EngGhaith/The-Silent-Owl-GF180MCU-WB-LNA/docs/sch_gen_v4.png

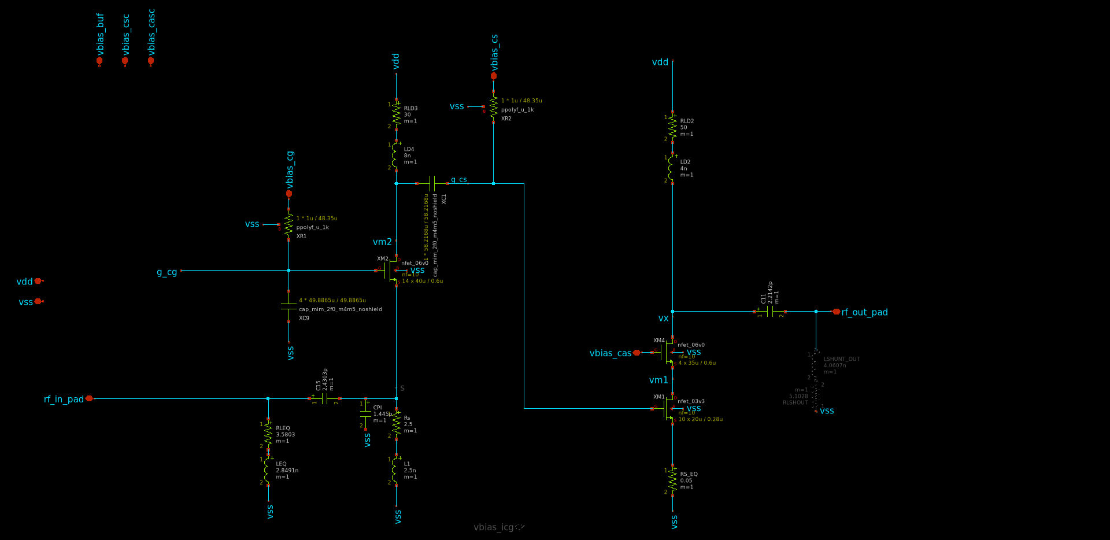
docs/sch_gen_v4.png
