EngGhaith/The-Silent-Owl-GF180MCU-WB-LNA/NFmin_Simulation/results/lna_sweep_analysis/plots_all_data/08_gmid_vs_vgs_nfet_05v0_CS.png

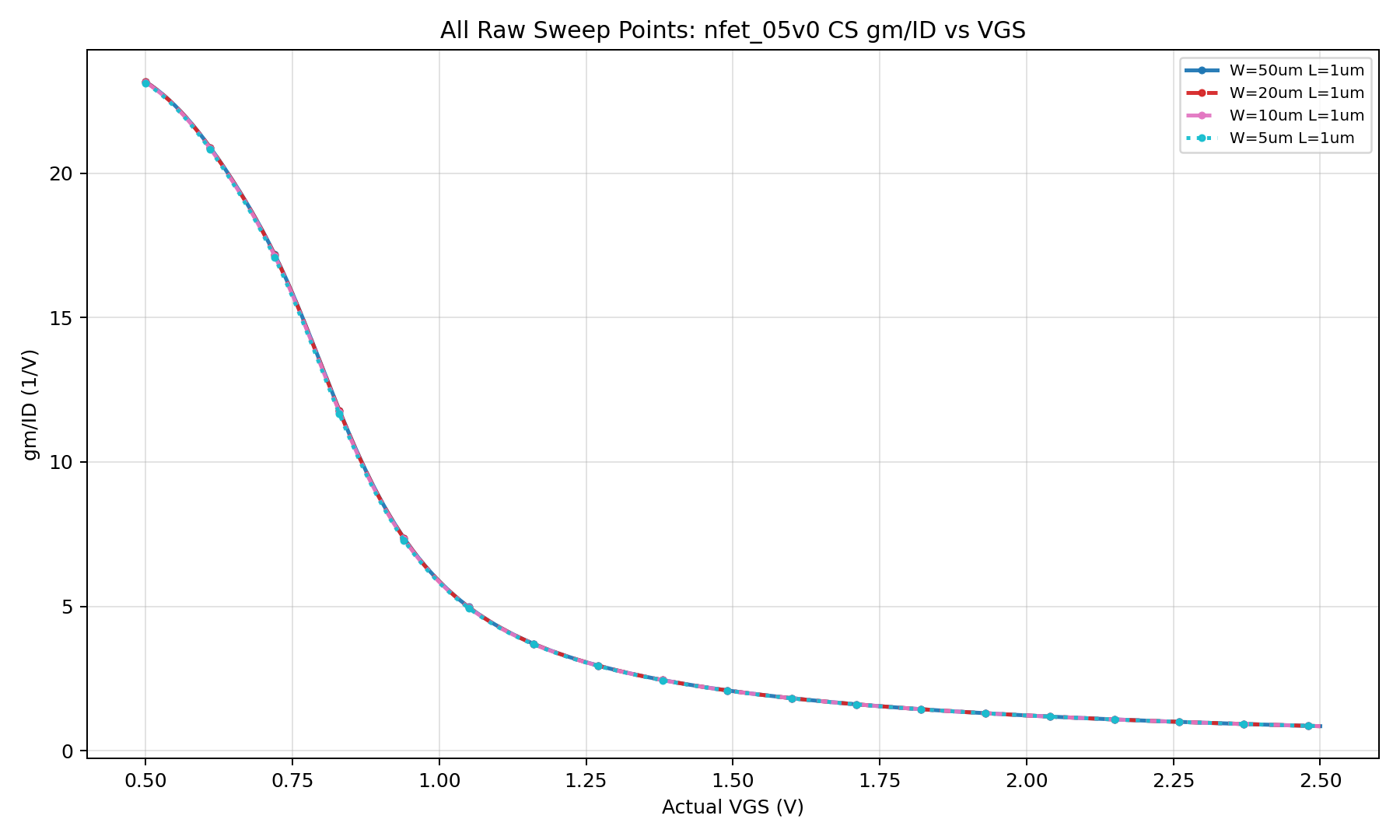
NFmin_Simulation/results/lna_sweep_analysis/plots_all_data/08_gmid_vs_vgs_nfet_05v0_CS.png
