EngGhaith/The-Silent-Owl-GF180MCU-WB-LNA/NFmin_Simulation/results/lna_sweep_analysis/plots_all_data/08_gmid_vs_vgs_nfet_10v0_asym_CG.png

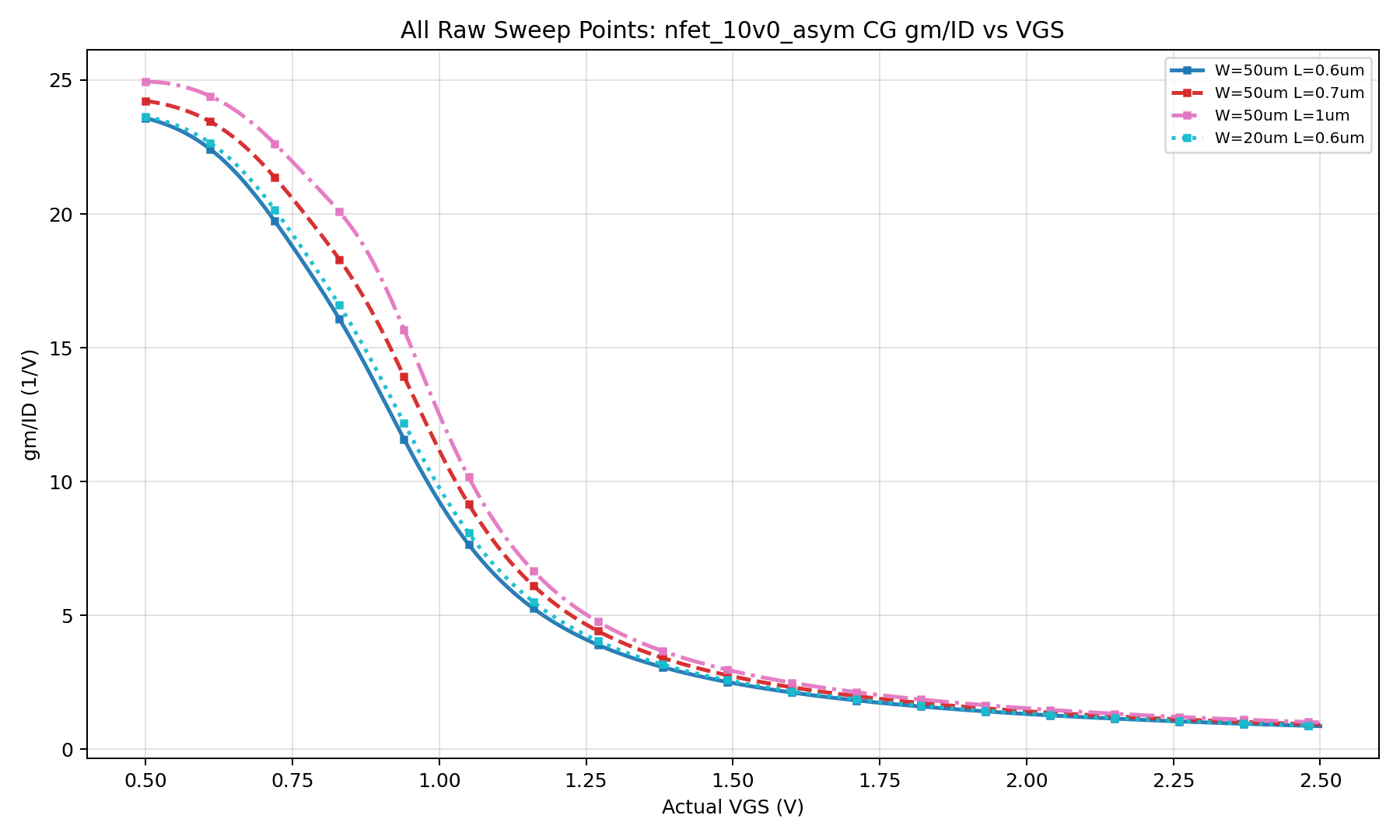
NFmin_Simulation/results/lna_sweep_analysis/plots_all_data/08_gmid_vs_vgs_nfet_10v0_asym_CG.png
