EngGhaith/The-Silent-Owl-GF180MCU-WB-LNA/NFmin_Simulation/results/lna_sweep_analysis/plots_all_data/09_gmgds_vs_gmid_all.png

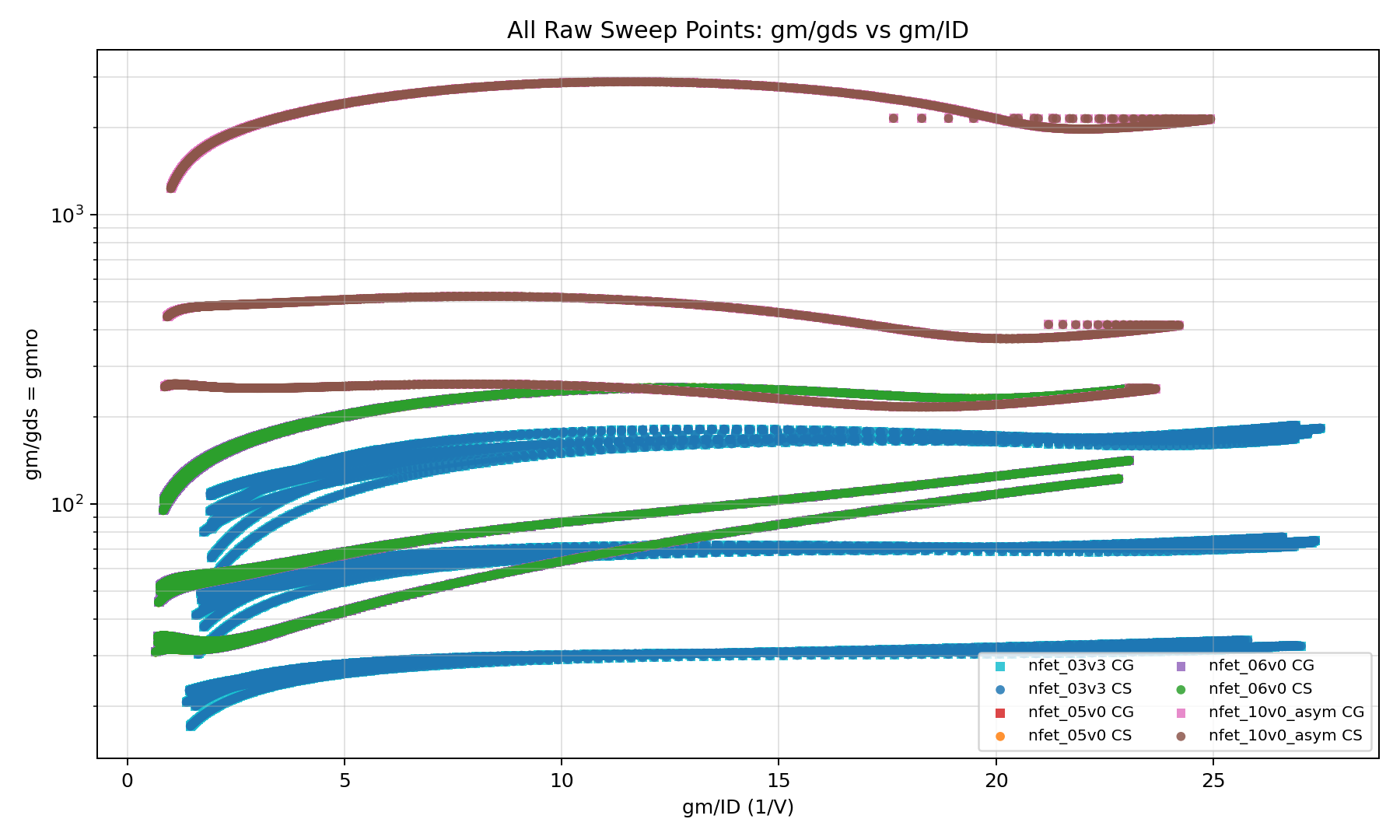
NFmin_Simulation/results/lna_sweep_analysis/plots_all_data/09_gmgds_vs_gmid_all.png
