EngGhaith/The-Silent-Owl-GF180MCU-WB-LNA/NFmin_Simulation/results/lna_sweep_analysis/plots_filtered_usable/08_gmid_vs_vgs_nfet_05v0_CG.png

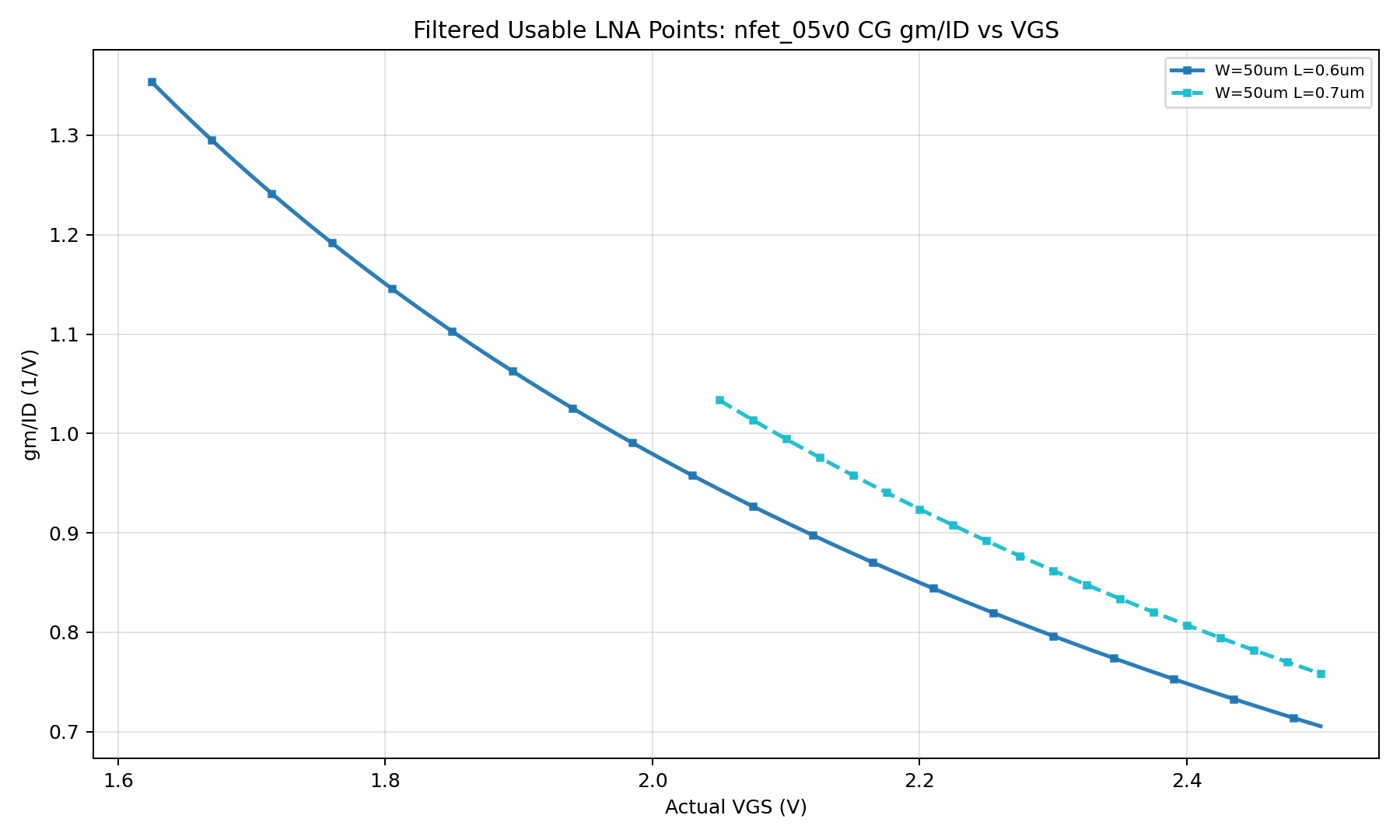
NFmin_Simulation/results/lna_sweep_analysis/plots_filtered_usable/08_gmid_vs_vgs_nfet_05v0_CG.png
