EngGhaith/The-Silent-Owl-GF180MCU-WB-LNA/(commit log)

2026-07-01 Updated nfmin results plots
    [lna_core_06V.sch]
2026-07-02 Updated io pad symbol & LNA core schem
    [lna_core_06V_1.sch, lna_core_06V_sweep.sch]
2026-07-05 add schematic
    [LNA_sim.sch, LNA_sim_test.sch, bandgap.sch, bandgap_tb.sch, bias_current.sch, lna_first_stage.sch, lna_second_stage.sch, lna_third_stage.sch]
2026-07-07 ULNA core schem
    [lna_core_06V_1.sch]
2026-07-12 Added schem of lna core
    [lna_core_06V_cgcs.sch]
2026-07-17 10V LNAs
    [10V0-CG-STG1.sch]
2026-08-05 update lna core & tb
    [10V0-CG-STG1.sch, bandgap.sch, bandgap_tb.sch, bias_current.sch, lna-core_tb.sch, lna_core.sch, lna_core_06V_cgcs_1.sch, lna_core_06V_cgcs_2.sch]
2026-08-05 update lna core
    [lna-core_tb.sch, lna_core.sch]
2026-08-06 Adjusted to fit IIC docker
    [lna-core_tb.sch]
2026-10-02 Add LNA configurability comparison: 8 retuned variants, what changed, why 3 remain
    Documents the shunt+series-cap-only retuning study across GNSS L1/L2
    and LoRa EU868/433 on both dev_ilir and dev_ghaith: exact per-branch
    schematic component changes, re-simulated S-parameter/noise results
    for all 8 variants, and the reasoning for carrying forward only
    dev_ghaith_gnssl1, dev_ghaith_gnssl2, and dev_ghaith_loraeu868 (LoRa
    EU433 fails structurally on both branches; dev_ghaith's three surviving
    bands beat dev_ilir's equivalents on current draw, input match, and
    topology robustness at the low end).
2026-10-02 Optimize bias point for best S11/S21/S22/NF/bandwidth around 2.4GHz
    Single-variable sensitivity sweep across all 7 live bias pins
    (VBIAS_CG, CS, CAS, ICG, CASC, CSC, BUF), then joint verification,
    against the full S-param/noise bench. VBIAS_BUF was swept too but
    excluded: it trades S22 badly (down to -10dB) for S21 gain, not a
    net improvement.
    VBIAS_CS 1.20V -> 1.38V, VBIAS_CAS 3.70V -> 4.30V, VBIAS_CSC 0.90V -> 1.035V
    (VBIAS_CG, ICG, CASC, BUF left at original defaults -- already at or
    near their own local optima).
    At 2.4GHz: S21 17.78->18.39dB, NF 3.21->3.18dB, S11 -18.85->-18.68dB,
    S22 -15.51->-16.03dB, 10dB-gain fractional bandwidth 90.4%->101.4%.
    Improvement on every target metric; co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
    [lna-core_tb.sch]
2026-10-02 Fix S11 degradation: enlarge C2 (input coupling cap)
    C2 is the input-side twin of C3 (which fixed S22 in the previous
    commit) -- a series AC-coupling cap from the input match network
    (LIN/RLIN) into M2's source. Same mechanism: its fixed 58.2168u
    (6.78pF) reactance grows as frequency drops (-9.8ohm at 2.4GHz ->
    -54.1ohm at 433.9MHz), tracking the Zin degradation almost exactly.
    Enlarging it the same way C3 was fixes S11 and improves S21/NF as a
    side effect (same reasoning as C3: the old mismatch reflected signal
    before it reached the active device). Result: 2.4GHz: S11=-18.69->-24.0dB S21=18.39->18.44dB.
    [lna_core.sch]
2026-10-03 Update configurability comparison; add main core native-vs-adjusted report
    docs/lna_configurability_comparison.html: extends the 8-branch
    (dev_ilir/dev_ghaith) comparison to all 15 variants across 3
    topologies (dev_ilir, dev_ghaith, main), each at its native 2.4GHz
    plus GNSS L1/L2 and LoRa EU868/433. Adds per-topology schematics,
    transistor-level gm/Id tables, and per-band 3-way comparison tables
    and charts (S21, S22) including total current (ICORE/PDC). Updated
    to reflect the C2 fix below.
    docs/main_core_tuning_report.html (new): as-committed `main` vs the
    fully tuned result (bias re-optimization + C8/C5/C2/C3 cap changes)
    across the same 5 bands, with before/after charts and a component
    c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
2026-10-05 removed cancellation manually from main
    [lna_core.sch]
2026-10-05 Re-optimize 2.4GHz biases and passives after cancellation removal
    Removing the noise-cancellation path (M7/M9 + support passives)
    changes the DC/AC loading at node vx and node s, so the prior
    with-cancellation bias/cap optimum no longer applies. Resimulated
    and reoptimized from scratch at 2.4GHz:
    Bias (single-variable sweeps, cheapest-current winners kept):
    - VBIAS_CAS 3.70 -> 4.80 (cascode gate, ~1mA cost, +0.4dB S21, +1.2dB S22)
    - VBIAS_ICG 1.90 -> 2.10 (CG current-sink gate, ~0.4mA cost, +2.7dB S11)
    - VBIAS_CG and VBIAS_CS left at their existing defaults: both were
    already at or near their local optimum, and pushing VBIAS_CS higher
    only trades current for a marginal S21 gain (not wor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
    [lna-core_tb.sch, lna_core.sch]
2026-10-05 Add main_no_cancellation to the configurability comparison; redraw schematics with schemdraw
    Extends the 3-topology/5-band comparison to the 4th variant created
    this session (main's noise-cancellation path removed and the whole
    circuit re-optimized from scratch): recipe table, gm/Id table, and
    full S11/S21/S22/NF-vs-frequency curves at all 5 bands, sourced from
    the actual pushed branches (main_no_cancellation_retuned and its
    _gnssl1/_gnssl2/_loraeu868/_loraeu433 relocations).
    Replaces the old hand-coded inline-SVG schematic functions with real
    schemdraw-generated diagrams (docs/img/schem_*.svg) for all 4
    topologies, color-coded by what changes when a circuit is adapted:
    - green: adjusted ba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
2026-10-06 main: RF-choke + bypass the CG tail current source to cut its noise
    main (no-cancellation core) has M5, the active current-sink degenerating
    the CG stage (M2), with its drain tied directly to node s -- the same
    node the RF input couples into via C2. M5's own drain thermal noise
    current injects directly into this low-impedance signal node, which is
    a large part of why this topology's NF (2.98dB at 2.4GHz) trails
    dev_ilir's (2.35dB), which instead uses a noiseless passive
    degeneration inductor.
    Rather than replacing M5 outright (that would require a full topology
    change and bias re-derivation, as was done for dev_ilir), this inserts
    a series inductor LCHOKE between node s and M5's drain (now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
    [lna-core_tb.sch, lna_core.sch]
2026-10-07 main_lowtailnoise: re-match against the real PEX-extracted pad
    The idealized behavioral pad model used throughout this project
    (gf180mcu_fd_io__asig_5p0) massively underestimates the real pad's
    parasitic loading. Resimulating with the Magic-extracted PEX netlist
    (analog_pad_sp_paramerters/spice_files/..., ~19000 elements per pad
    instance, fixing a DVDD/ASIG5V pin-order mismatch in its .SUBCKT
    header vs the symbol) showed the existing match completely fails:
    S11=-1.86dB, S21=10.43dB, S22=-2.43dB, NF=5.33dB at 2.4GHz.
    Fix: a new shunt inductor at each pad (LSHUNT at rf_in_pad, LSHUNT_OUT
    at rf_out_pad) to resonate out the real pad's oversized capacitance,
    keeping the existing series LIN/LOUT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
    [lna-core_tb.sch, lna_core.sch]
2026-10-07 main_lowtailnoise_pexmatched: optimize 2.4GHz bias point (Icc<40mA)
    Empirically swept all 7 bias nodes (VBIAS_CG/CS/CAS/ICG/BUF/CSC/CASC)
    against the real PEX pad, first independently (1D sensitivity) then
    jointly over the promising directions, tracking DC current draw
    (ICORE_A from the testbench's own .control report) against the 40mA
    budget.
    Findings:
    - VBIAS_CSC and VBIAS_CASC have ZERO effect on S11/S21/S22/NF in this
    topology (dead nodes here, consistent with main_lowtailnoise's
    RF-choked/bypassed CG tail current source rework) -- left unchanged.
    - VBIAS_ICG (M5 gate, nfet_03v3/3.3V-rated, driven directly with no
    isolation resistor) gives a genuine free win when raised -- better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
    [lna-core_tb.sch]
2026-10-08 docs: add PEX-matched LNA variants report
    Self-contained HTML report covering the five currently-active
    PEX-pad-matched designs: main_lowtailnoise_pexmatched (2.4GHz,
    bias-optimized) plus its GNSS L1/L2 and LoRa EU868 band relocations,
    and dev_ilir_pexmatched (2.4GHz). For each: an overview table,
    a hoverable S11/S21/S22/NF sweep chart spanning the full
    200MHz-7GHz simulated range (not just each variant's own narrow
    band, to show real out-of-band behavior), the shared matching-network
    topology with fixed-vs-per-band-tuned components called out, a full
    component-value table across bands, and the shared bias-optimization
    note.
    All data pulled directly from the project's own confirmed ngspice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
2026-10-08 docs: drop RLIN/RLSHIN/RLOUT/RLSHOUT rows from the component table
    These Q=12 inductor-loss resistor values clutter the table without
    adding much for a reader comparing caps across bands; the underlying
    physical inductors (LIN/LSHUNT/LOUT/LSHUNT_OUT) are already called
    out as fixed in the topology diagram and bias note.
2026-10-08 docs: add transistor sizing/gm-Id and fixed-component tables
    Two new sections:
    - Transistor sizing & DC bias point: L/W plus simulated gm, Id and
    gm/Id (ngspice .op, not schematic parameters) for every transistor
    in main_lowtailnoise_pexmatched (M1-M6) and dev_ilir_pexmatched
    (M1/M2/M4 -- it has no output-buffer/RF-choke stage). Confirmed the
    DC operating point is identical across all four main_lowtailnoise
    bands, since only caps/resistors changed (DC-open/DC-short, no
    effect on bias).
    - Fixed (non-changing) components -- main_lowtailnoise: everything
    NOT in the existing per-band table (LIN/LSHUNT/LOUT/LSHUNT_OUT/LD2,
    the gate-bias and tank-adjacent resistors R1/R2/R4/R5/R7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
2026-10-08 Refined schematic style
    [lna-core_tb.sch, lna_core.sch]
2026-10-08 main_lowtailnoise_pexmatched: CG-drain shunt-peaking load (R4 -> LD1+RLD1)
    Replace the CG stage's resistive drain load (R4, ppolyf_u) with a series
    inductor+resistor shunt-peaking load (LD1=8nH, RLD1=30 ohm), matching the
    precedent already established on dev_ilir_pexmatched's LD4/RLD3. An ideal
    inductor is a DC short, so this doesn't change M2's bias point -- only the
    AC gain at vm2, which feeds the noise-cancellation coupling path via C1.
    Verified via the project's standard broadband S-parameter testbench at
    2.4GHz: S21 improves from 18.08dB to 28.65dB (+10.6dB, confirmed broadband
    across the full 2.04-2.76GHz sweep, not a narrow resonance), at the cost
    of S11 -25.42->-23.83dB, S22 -29.96-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
    [lna_core.sch]
2026-10-09 docs: add CG-tank shunt-peaking variants to the PEX-matched comparison
    Append 4 new rows ("+ CG tank") to the existing 5-variant comparison,
    one per main_lowtailnoise_pexmatched band, showing the CG stage's
    R4 -> LD1+RLD1 shunt-peaking load upgrade (already committed on each
    band's branch). Same 300-point schematic-generated sweep methodology
    as the existing rows, against the real PEX pad netlist.
    Headline: a large, consistent S21 gain increase (+10 to +16dB) across
    all four bands, funded partly by spending some of each band's input/
    output match margin -- still comfortably inside the -10dB spec in every
    case. NF improves at 3 of 4 bands and is roughly flat at 2.4GHz.
    Note: the existing "F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
2026-10-10 docs: add cascode optimization follow-up and fix mis-scaled chart
    Adds a full optimization investigation (body-tie, M2C sizing, drain
    peaking inductor, gate bias, matching-network retune) with device-config
    labels on every plot, hoverable tooltips/crosshairs on all charts, and
    a verified 1MHz-15GHz sweep of the best practical configuration.
    Also fixes a real bug: the +cascode S21/S11/S22/NF curves were plotted
    using the baseline's frequency array even though the cascode case had
    only been simulated over a much narrower band, stretching its data
    across the full axis and making it look wideband. Re-simulated the
    untuned cascode over the full 1MHz-15GHz range and fixed the chart to
    use each se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
2026-10-11 Fix testbench so it runs immediately without post-processing
    lna-core_tb.sch's MODELS code block referenced $::180MCU_MODELS, a Tcl
    global that isn't set in this environment's xschemrc, so the tcleval'd
    .include/.lib paths resolved to garbage. It also included the generic
    (non-PEX) IO pad model instead of the PEX-extracted one this project's
    comparisons depend on. Previously worked around per-run by a python
    post-processing script (fix_includes.py) outside the repo.
    Hardcode the resolved PDK model paths and the PEX pad path directly in
    the schematic, so `xschem -x -q -n lna-core_tb.sch -o <dir>` followed by
    `ngspice -b lna-core_tb.spice` works standalone with no extra scripting.
    Verified: r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
2026-10-12 docs: add bias voltages to chosen_topologies.html
    Extends the existing main_lowtailnoise bias note with the two
    previously-omitted dead-node values (VBIAS_CASC, VBIAS_CSC) and VDD, for
    a complete bias-point snapshot. Adds a new section with dev_ilir_pexmatched's
    own, separately-optimized bias ladder (VDD, VBIAS_CAS/CASC/CG/ICG/BUF/CS/CSC),
    which the report previously didn't cover at all. All values re-extracted
    directly from a live ngspice .op run on each branch's (now standalone-
    runnable) testbench, not carried over from memory.
2026-10-12 docs: fix stale fixed-components table and schematic image
    Found while helping a user debug a resimulation mismatch. The 'Fixed
    (non-changing) components' table and the embedded core-schematic image
    both predated the CG-drain shunt-peaking load commit (R4 -> LD1+RLD1):
    the table still listed the removed R4 resistor and never mentioned
    LD1/RLD1 at all, and the embedded image was from "the earlier low-tail-
    noise rework" per its own caption, i.e. before PEX matching and well
    before the CG-tank port.
    - Added LD1 (8nH) and RLD1 (30ohm), the actual CG-drain shunt-peaking
    load/tank that replaced R4; removed the stale R4 entry.
    - Added the previously-missing RLD2 (20.5ohm), paired with LD2.
    - Fi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
2026-10-14 Adopt gen_v4 as main's LNA circuit: Pi-matched input, generic-pad retune
    Replaces main's CG-drain shunt-peaking design with the gen_v4 circuit
    developed this session: same core CG/CS/cascode stage as the
    dev_ghaith/dev_ilir lineage, with its pad-facing matching network
    retuned against the generic (non-extracted) I/O pad instead of a
    PEX-extracted one, plus a Pi-match (added CPI shunt cap) that widens
    the matched bandwidth without the noise penalty of simply damping the
    input shunt inductor's Q.
    Generic pad fix file is the official-PDK-only version (the routing/
    substrate parasitic capacitance and extra ESD/clamp diodes in earlier
    "generic_pinfixed" files were never part of the actual GF180M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
2026-10-14 docs: add main vs main_pex comparison report
    Hoverable S11/S21/S22/NF charts (self-contained SVG/JS, no external
    dependency), schematics, full component listing, bias point, and a
    verified gm/Id + transistor-sizing table for both branches, plus a
    step-by-step migration guide for going from this branch's circuit
    (gen_v4, generic pad) to main_pex's (dev_ilir_pexmatched_singleL,
    real PEX-extracted pad).
2026-10-14 docs: make comparison report charts bigger and clearer
    Full-width stacked charts instead of a cramped 2-per-row grid, with
    roughly doubled font sizes, thicker trace lines, and bigger hover
    markers/tooltip text.
2026-10-17 Restructure LNA schematics, add layout floorplan and optimisation scripts
    - xschem: split LNA into lna_top / lna_bias / lna_core_{cs,cg,parts,input_match,output_match};
    remove obsolete first/second/third-stage and LNA_sim schematics
    - klayout: GDS of LNA core blocks and power-grid/decap cells, DRC reports
    - layout/floorplan: floorplan generator scripts, GDS/JSON/SVG outputs
    - sim/opt: LNA testbench evaluation and buffer/gain optimisation scripts
    - techsweep: add calculate.ipynb; ignore large simulation results and backups
2026-10-20 Add EM-validated real inductor coil layouts to klayout/
    The 4 physical spiral-inductor GDS cells backing the EM-derived L+R inductor
    models, carried over from the rapidpassives EM-characterization project:
    LEQ_coil.gds - D=284.75um, N=2/W=26um, 5-metal shunted, L=1.3723nH
    R=1.6674ohm @ 2.4GHz (DRC-clean, real via bridge)
    LSHUNT_OUT_coil.gds - D=390.59um, N=2/W=26um, 5-metal shunted, L=2.5041nH
    R=3.0693ohm @ 2.4GHz (DRC-clean, real via bridge)
    LD2_coil.gds - D=185um, N=3/W=1.75um, TM-only (deliberately lossy),
    L=4.30nH R=52.69ohm @ 2.4GHz (DRC-clean)
    LD4_coil.gds - D=300um, N=3/W=2um, TM+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
2026-10-20 Reapply inductor config sweep on top of PR #31's restructured lna_core.sch
    Cherry-picks the ideal/rl/snp2le config-sweep mechanism (previously
    archive/main-inductor-sweep) onto the current lna_core.sch. Resolved one
    conflict: PR #31 upgraded C11/C15/CPI from ideal capa.sym to real
    cap_mim_2f0fF.sym instances with extracted W/L -- kept those real values,
    applied only the LD4/L1 inductor substitution on top (LEQ and the standalone
    disabled LSHUNT_OUT instance are untouched, same as before -- main only
    sweeps LD2, LD4, and L1 via the LSHUNT_OUT_model).
2026-10-20 Add terminal resistors at every coil port; make LSHUNT_OUT 2-port
    Mirrors the same fix on main_pex, scoped to this branch's 3 swept slots
    (LD2, LD4, L1 via LSHUNT_OUT_model). See main_pex's commit for the full
    rationale (LVS correctness: avoid an implicit zero-impedance join between
    a device terminal and whatever net chip-level routing ties it into) and
    the GDS/sheet-resistance/DRC details -- same 4 coil layouts, same
    terminal resistor values (LEQ/LSHUNT_OUT 0.0038 ohm, LD2 0.0571 ohm, LD4
    0.0500 ohm per terminal; LEQ_coil.gds/LEQ_model.* carried along here too
    even though main doesn't sweep LEQ, for consistency with main_pex).
    LSHUNT_OUT_model is now synthetically 2-port (same series-imped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
2026-10-20 Use the PDK's own tm11k metal-resistor device for the terminal resistors
    Mirrors main_pex's commit, scoped to this branch's 3 swept slots (LD2,
    LD4, L1). Replaces the generic res.sym placeholders with symbols/rm1.sym
    instances set to model=tm11k -- GF180MCU's real parameterized top-metal
    resistor primitive (no "rm5" exists; the top metal resistor is named by
    its stack option -- tm11k for this project's TM11KA-MIMB/11K stack).
    Verified: netlists with zero errors; rl-config result at 2.4GHz is
    numerically identical to the previous (res.sym-based) commit.
2026-10-20 Shunt the terminal resistor across all metal layers (M1-M4 + TM)
    LD4, L1). See main_pex's commit for the full rationale (full native port
    width restored -- a narrow neck raises resistance, the opposite of what's
    wanted -- and real via-stitched multi-layer shunting matching how the
    rest of each coil is already built), the GDS/DRC details, and the m=
    multiplicity technique (rm1 at m=4, or m=3 at L1's vss terminal where M1
    is skipped as already-ground).
    unchanged to displayed precision from the single-TM-layer version.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
2026-10-21 Split the m=4 parallel-layer shortcut into separate per-layer devices
    LD4, L1). See main_pex's commit for the full rationale -- m=4 is an
    ngspice-only simulation shortcut, not LVS-matchable against 4 physically
    distinct per-layer devices -- and the routing approach (empty staging
    area, label-matching only, two real short-circuit bugs caught along the
    way and fixed).
    identical to the m=4 version.
    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
2026-10-21 Make terminal resistors genuinely LVS-clean; revert sim schematic to plain inductors
    Same fix as main_pex: LEQ, LSHUNT_OUT, LD2, LD4 all get a neck-cut +
    external bridge-wire + pin-label treatment that gives KLayout's GF180MCU
    LVS deck genuine two-terminal rm1-4/tm11k devices (the previous dead-end
    via-stitched stub could never be recognized as a real device -- confirmed
    by direct extraction showing zero devices written despite correct
    markers). LEQ/LSHUNT_OUT are updated here too even though neither is
    swept directly on this branch, since L1's physical cell IS
    LSHUNT_OUT_coil.gds (a pure schematic-level model reuse, no separate GDS
    of its own) -- keeping both branches' copies in sync.
    Root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
2026-10-25 Add EM-characterized LEQ_MAIN coil for main's input-matching shunt inductor
    main's RF-input shunt element (rf_in_pad -> RLEQ -> LEQ -> vss in
    lna_core.sch / lna_core_input_match.sch) was a discrete ideal pair:
    LEQ=2.8491n (target) + RLEQ=3.5803 ohm (assumed/guessed, not extracted).
    main_pex already has a real EM-characterized LEQ_model, but it targets a
    different, smaller L (1.333nH, D=284.75um) for its own matching network --
    not reusable here.
    Synthesized a new coil for the 2.8491nH target using the exact same
    openEMS flow and N=2/W=26/S=2/STACKED4 spiral-shunt methodology already
    validated for LSHUNT_OUT/LEQ in rapidpassives/try4/newflow/: diameter
    predicted from a power-law fit (L=k*D^1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
2026-10-31 xschem: remove g_cg external port from lna_core_cg, add shunt cap on cs cascode gate
    The CG stage's cascode gate (M2, internal net g_cg) is already locally
    biased and decoupled on-chip via R1 (from vbias_cg) and C9 (49.8865u x
    49.8865u, m=4, to vss), so breaking it out as a separate top-level pin
    is unnecessary. Remove the g_cg port from lna_core_cg.sym/.sch and
    unwind its pass-through wiring/pin mapping at every higher hierarchy
    level that carried it (lna_core_parts.sym/.sch, lna-core_tb.sch),
    including an orphaned V3/net3 probe branch in the testbench that only
    stayed connected via the now-removed g_cg label and would otherwise be
    left as a floating, no-DC-path node. (lna_core.sch keeps it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
